Wool5443/Tiny2313-Clock/art/clock.png

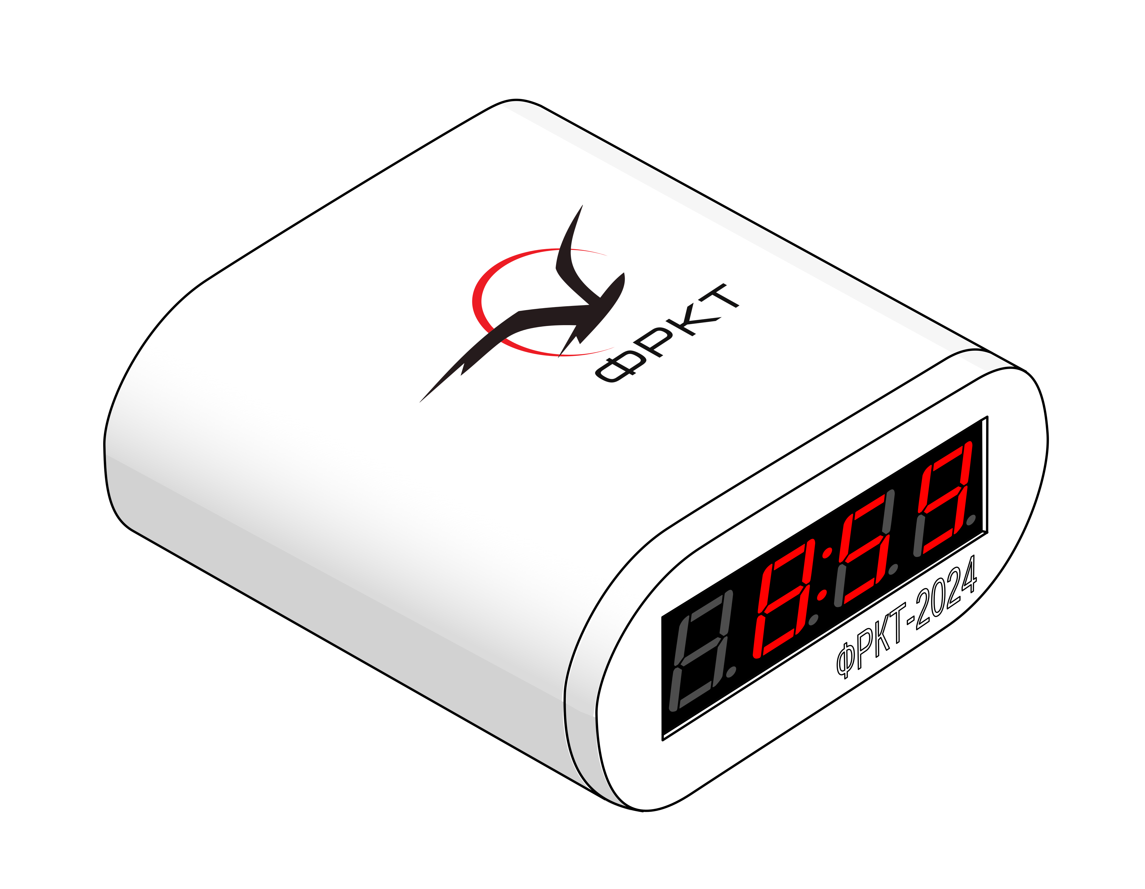
art/clock.png
