Wool5443/Tiny2313-Clock/pdf/cover.pdf

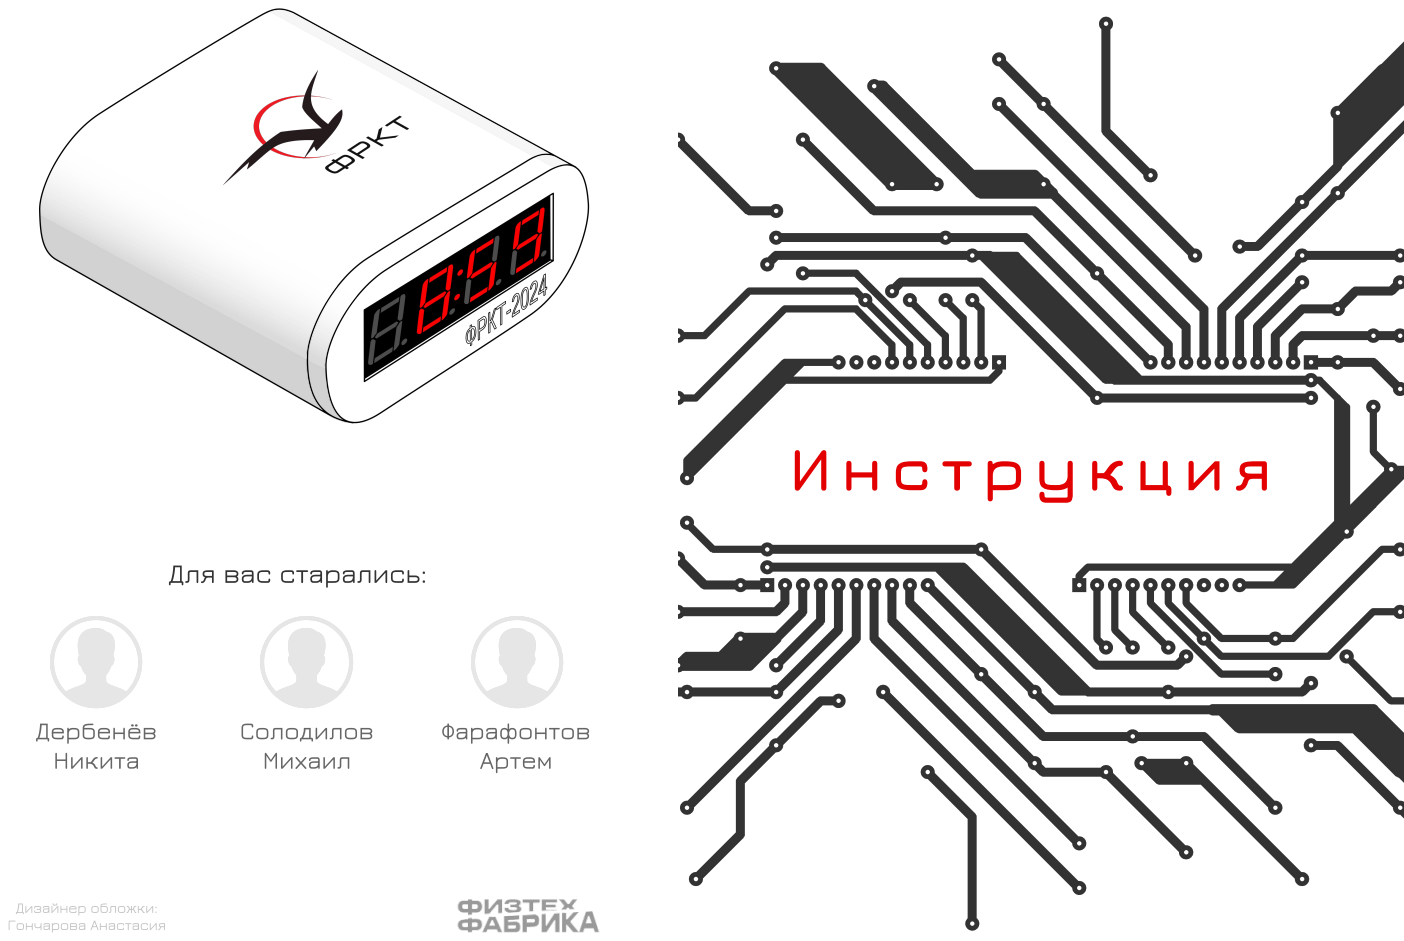
[picture p2: page 1]
Дербенёв; Никита; Солодилов; Михаил; Фарафонтов; Артем; Дизайнер обложки:; Гончарова Анастасия

Для вас старались:
