Wool5443/Tiny2313-Clock/(list of files, drawings)

Other design files:
clock.lay6
