Wool5443/Tiny2313-Clock/(commit log)

2024-03-23 Now can show time, currently set ot mins/secs
2024-04-13 Fix buttons
2024-04-15 Move files
    [clock.lay6]
